frankyhub/RoboCar/3D/PIN_4mmV4.stl

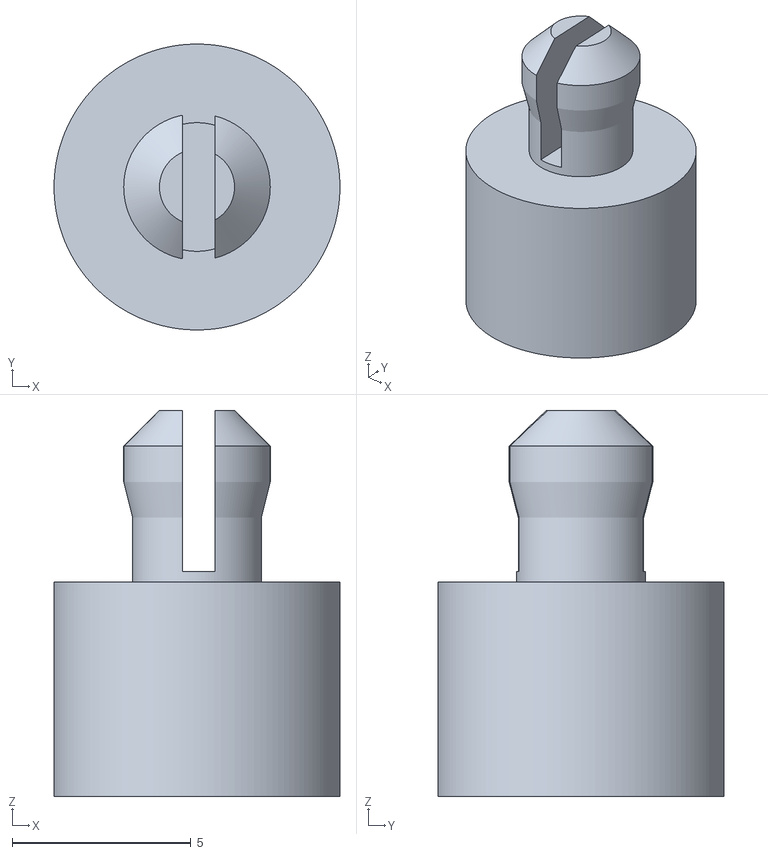
[picture p12: CAD file, 2024-06-01]
3D/PIN_4mmV4.stl
8.00 x 8.00 x 10.8
